zenitheesc/garatea3/Structure/main-structure/internal-assembly.SLDASM

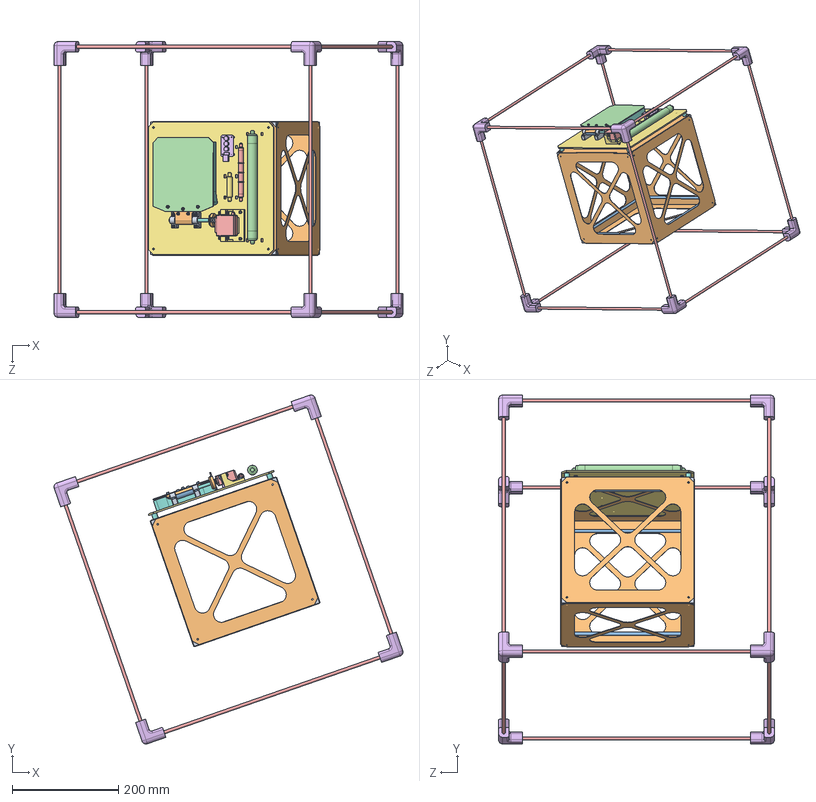
[picture p1: CAD file, 2021-04-19]
Structure/main-structure/internal-assembly.SLDASM
657.4 x 657.4 x 520.0 mm
Conector-int_1 x 8
Placa-ext_1 x 6
tubo-int-hor_1 x 8
tubo-int-vert_1 x 4
Tubo-ext_1 x 12
Conector-ext_1 x 8
chapa
base_experimento
mancal1 x 2
suporte_tampa
suporte_tampa2
tampa_experimento
Servo_motor_maior
hex nut style 1_am x 7
suporte_servo
eixo
uniao_servo
uniao_eixo1
socket head cap screw_am x 13
geiger_maior
geiger_CTC5
placa_fotodiodos
geiger_SI3BG
espaçador x 4
