zenitheesc/garatea3/Structure/main-structure/external-assembly.sldasm

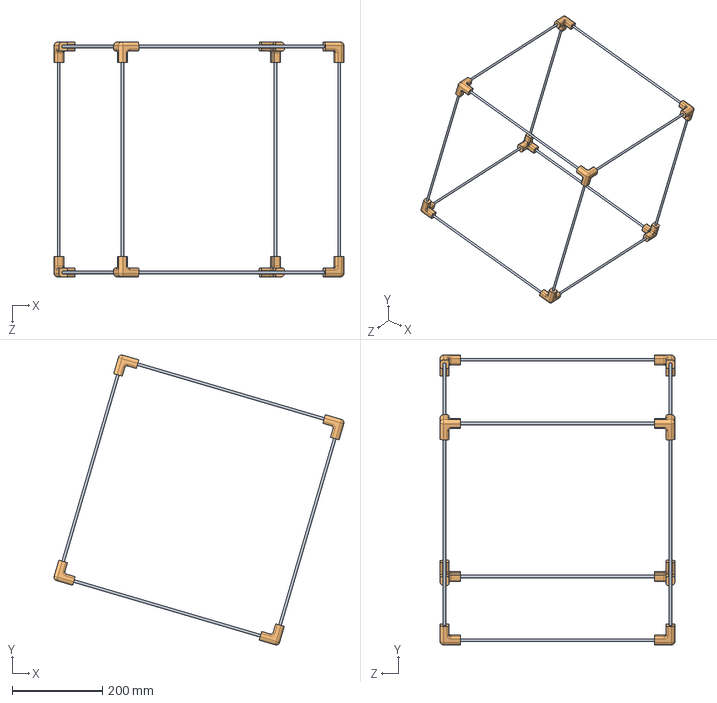
[picture p2: CAD file, 2021-04-19]
Structure/main-structure/external-assembly.sldasm
641.6 x 641.6 x 520.0 mm
Tubo-ext_1 x 12
Conector-ext_1 x 8
