zenitheesc/garatea3/Structure/main-structure/final-assembly.SLDASM

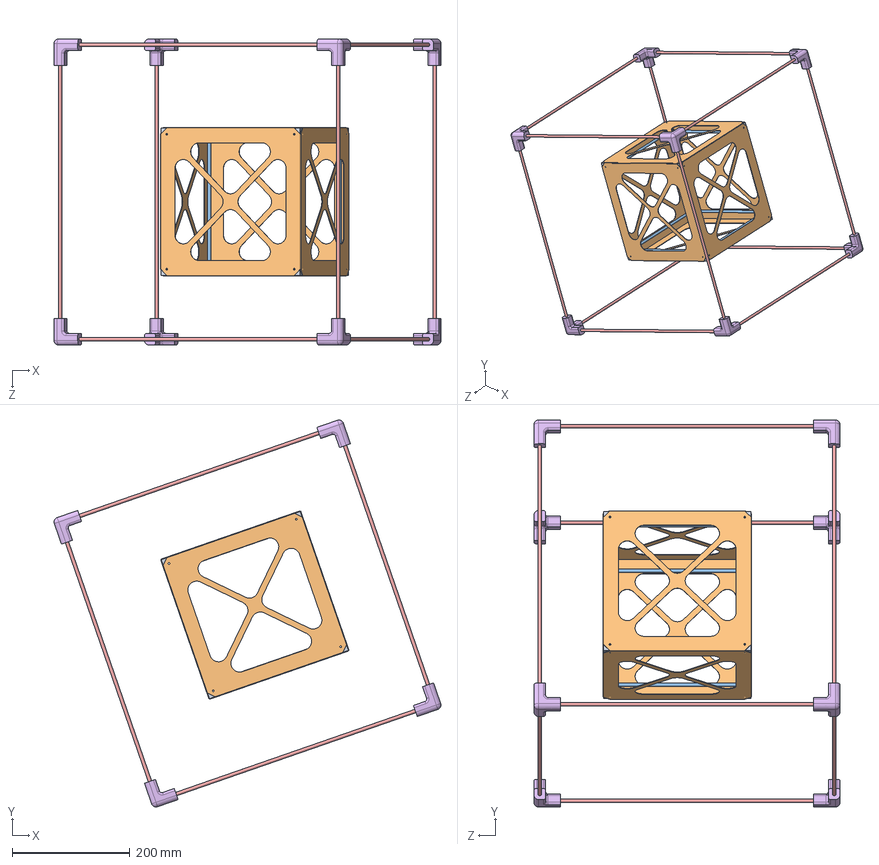
[picture p3: CAD file, 2021-04-19]
Structure/main-structure/final-assembly.SLDASM
657.4 x 657.4 x 520.0 mm
Conector-int x 8
Placa-ext x 6
tubo-int-hor x 8
tubo-int-vert x 4
Tubo-ext x 12
Conector-ext x 8
