zenitheesc/garatea3/Structure/mechanism/support-slave.STL

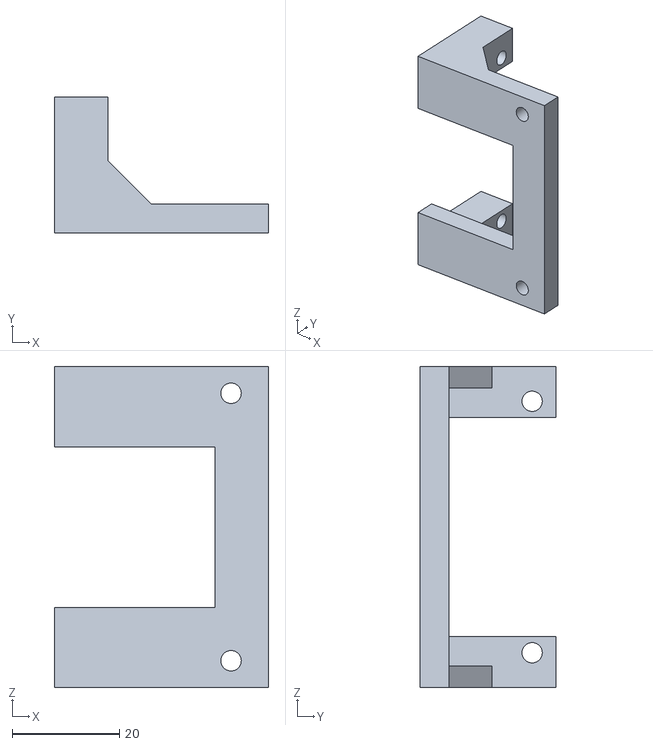
[picture p4: CAD file, 2021-04-19]
Structure/mechanism/support-slave.STL
40.0 x 25.5 x 60.0
