zenitheesc/garatea3/Structure/mechanism/union.STL

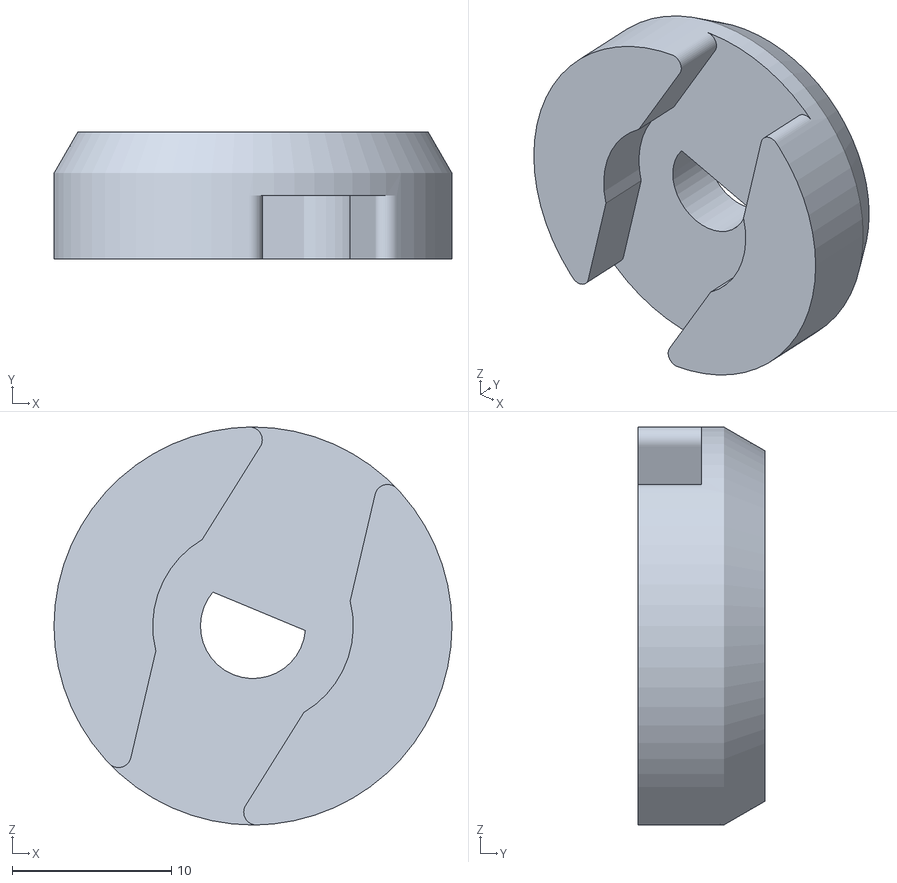
[picture p5: CAD file, 2021-04-19]
Structure/mechanism/union.STL
25.0 x 8.00 x 25.0
