zenitheesc/garatea3/Structure/main-structure/external-board.sldprt

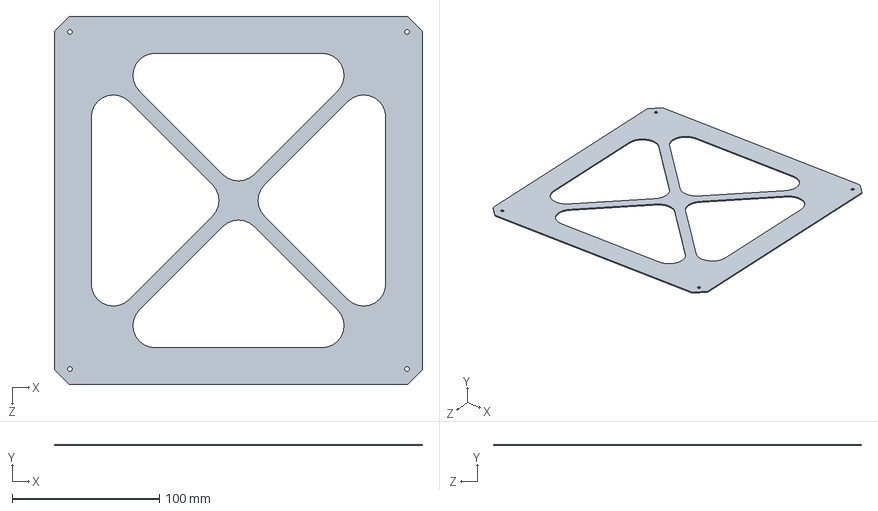
[picture p6: CAD file, 2021-04-19]
Structure/main-structure/external-board.sldprt
250.0 x 1.00 x 250.0 mm
