zenitheesc/garatea3/Structure/mechanism/bearing.STL

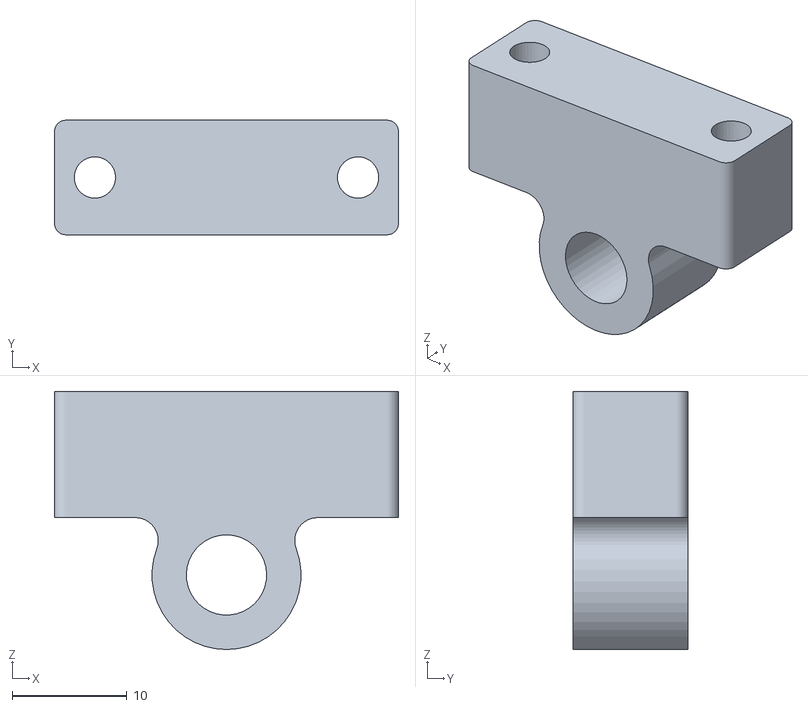
[picture p7: CAD file, 2021-04-19]
Structure/mechanism/bearing.STL
30.0 x 10.0 x 22.5
