zenitheesc/garatea3/Structure/main-structure/internal-vertical-tube.sldprt

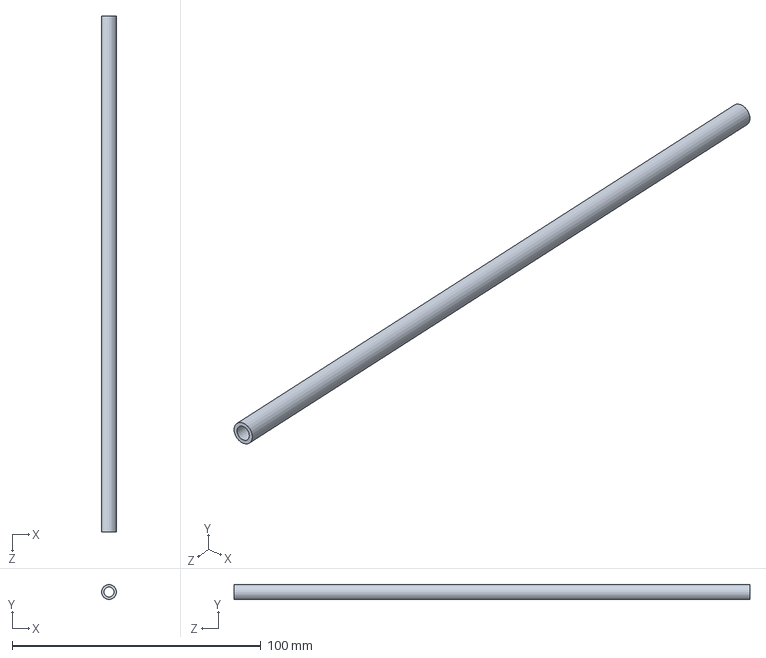
[picture p8: CAD file, 2021-04-19]
Structure/main-structure/internal-vertical-tube.sldprt
6.00 x 6.00 x 207.5 mm
