zenitheesc/garatea3/Structure/mechanism/support-cover.STL

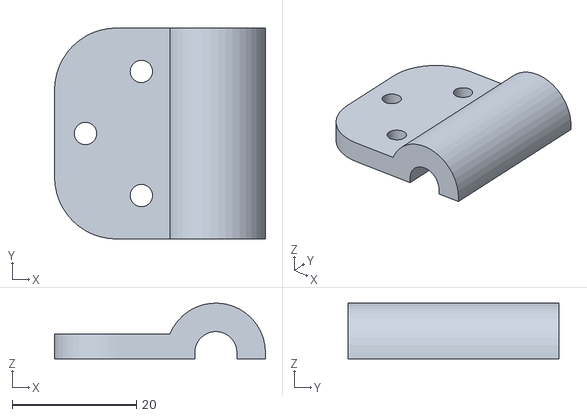
[picture p9: CAD file, 2021-04-19]
Structure/mechanism/support-cover.STL
34.0 x 34.0 x 8.99
