zenitheesc/garatea3/Structure/main-structure/internal-horizontal-tube.sldprt

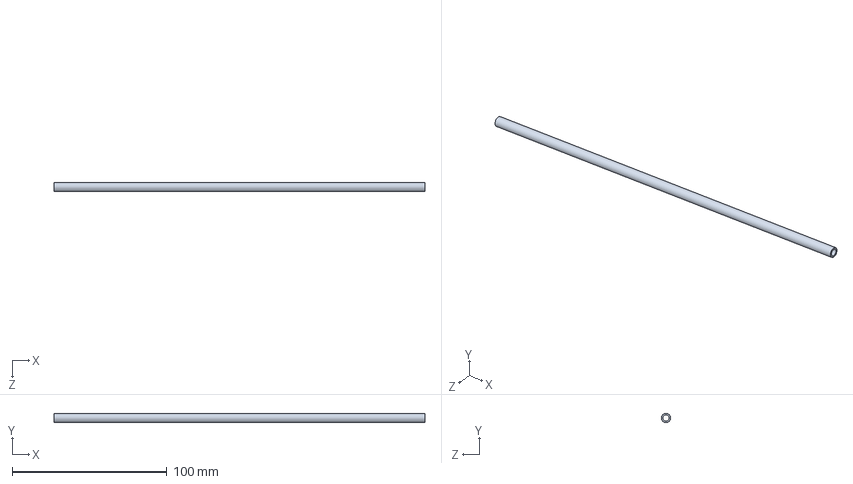
[picture p10: CAD file, 2021-04-19]
Structure/main-structure/internal-horizontal-tube.sldprt
240.0 x 6.00 x 6.00 mm
