zenitheesc/garatea3/Structure/mechanism/experiment-base.STL

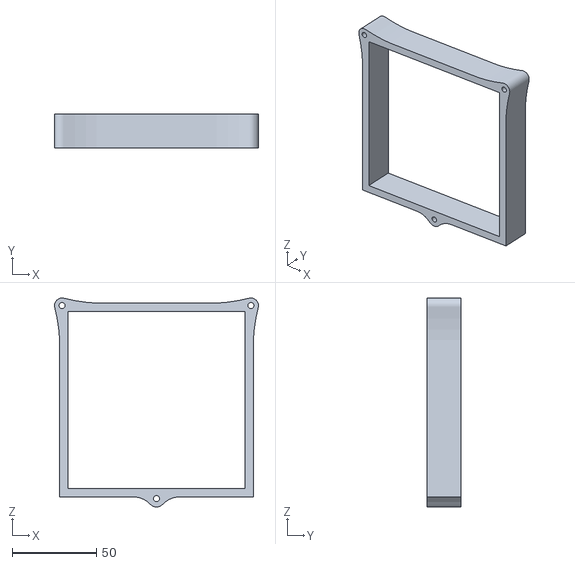
[picture p11: CAD file, 2021-04-19]
Structure/mechanism/experiment-base.STL
121.1 x 20.0 x 124.0
