zenitheesc/garatea3/Structure/main-structure/internal-connector.stl

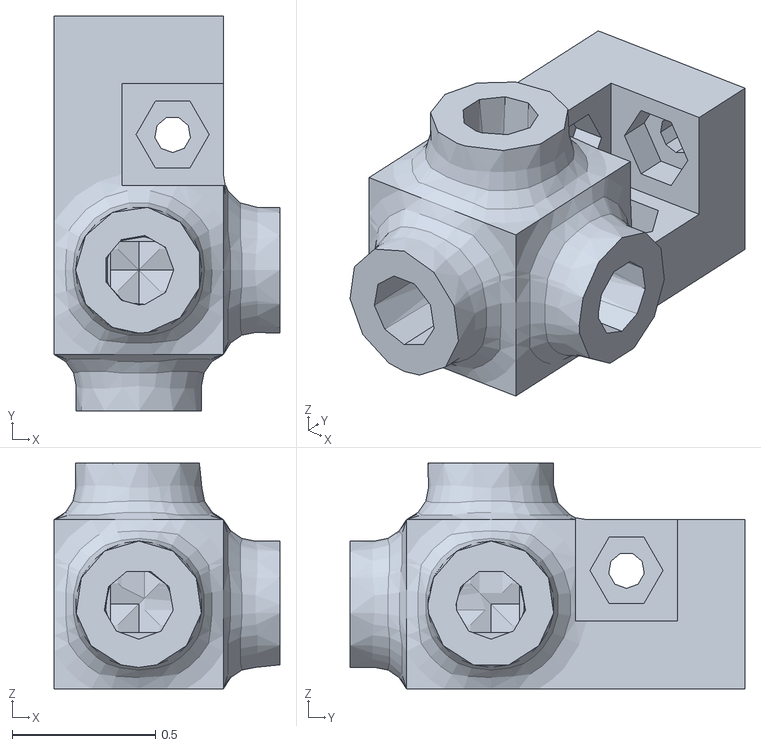
[picture p12: CAD file, 2021-04-19]
Structure/main-structure/internal-connector.stl
0.787 x 1.38 x 0.787
