zenitheesc/garatea3/Structure/main-structure/external-connector.stl

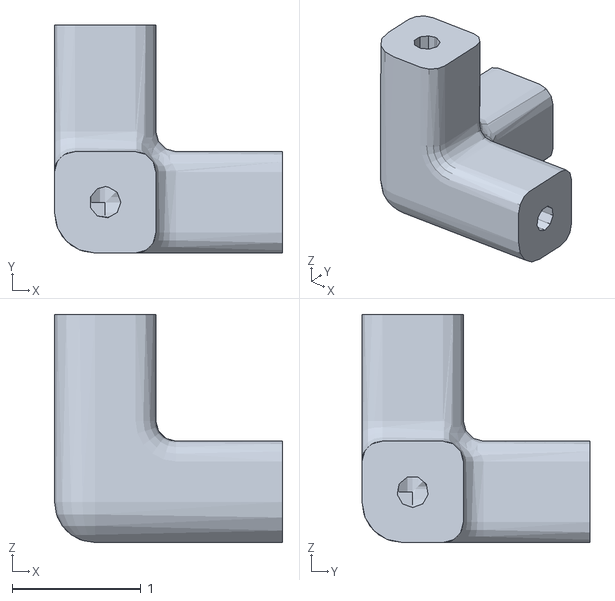
[picture p13: CAD file, 2021-04-19]
Structure/main-structure/external-connector.stl
1.77 x 1.77 x 1.77
