zenitheesc/garatea3/Structure/main-structure/external-tube.sldprt

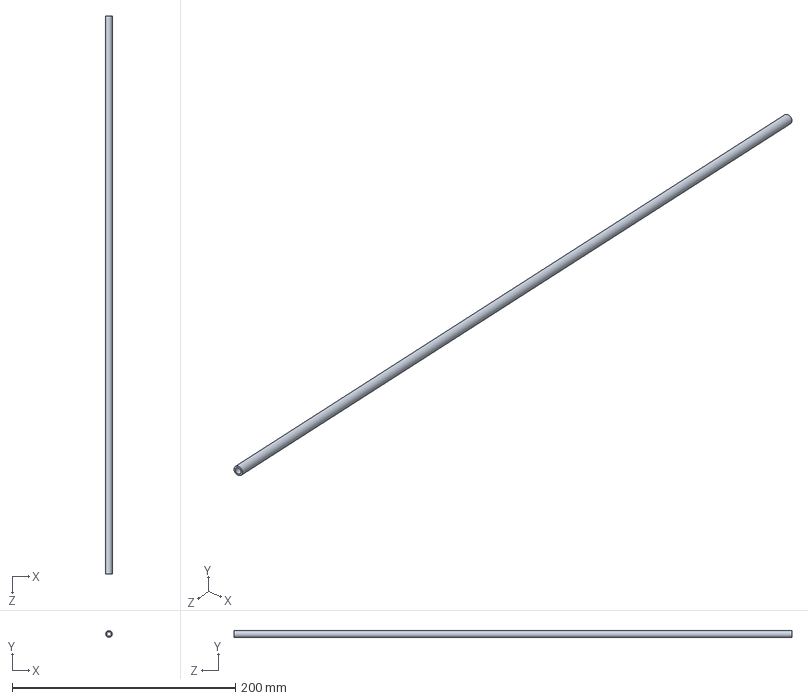
[picture p14: CAD file, 2021-04-19]
Structure/main-structure/external-tube.sldprt
6.00 x 6.00 x 500.0 mm
