zenitheesc/garatea3/(list of files, cad)

Other CAD files:
Structure/main-structure/external-assembly.stl
Structure/main-structure/external-board.stl
Structure/main-structure/external-tube.stl
Structure/main-structure/internal-horizontal-tube.stl
Structure/main-structure/internal-vertical-tube.stl
