zenitheesc/garatea3/Hardware/photodiodes-board/photodiodes-board.brd

## EAGLE design Hardware/photodiodes-board/photodiodes-board.brd (2021-04-19)

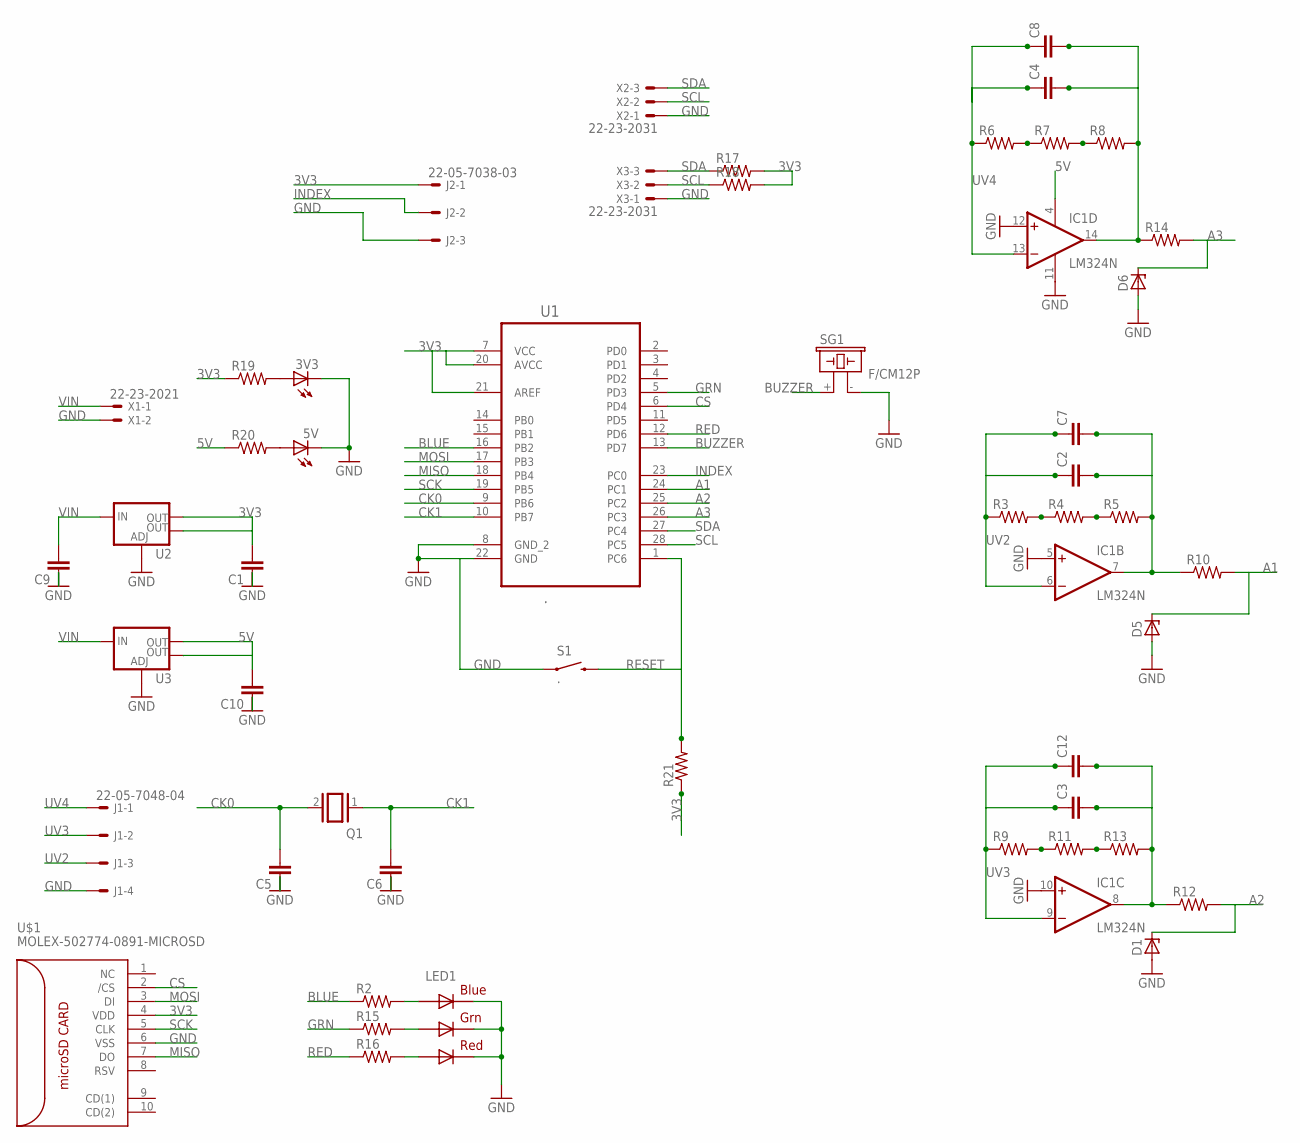
[picture p15: schematic photodiodes-board.sch]

Parts:
3V3, 5V: LEDSMT1206; 1206
C1, C2, C3, C4, C5, C6, C7, C8, C9, C10, C12: 10UF-1210-50V-20%; 1210
D1, D5, D6: ZENER-DIODEZD-12.5; ZDIO12.5
IC1: LM324N; DIL14
J1: 22-05-7048-04; 7395-04
J2: 22-05-7038-03; 7395-03
LED1: .; RGBLED5050
Q1: XTAL/S; QS
R2, R10, R12, R14, R15, R16, R17, R18, R19, R20, R21: R-US_M1206; M1206
R3, R4, R5, R6, R7, R8, R9, R11, R13: R-US_0207/12; 0207/12
S1: .; TACTILE-SWITCH-1101NE
SG1: F/CM12P
U1: .; DIP254P762X457-28
U2, U3: V_REG_LM1117SOT223; SOT223
U$1: MOLEX-502774-0891-MICROSD
X1: 22-23-2021
X2, X3: 22-23-2031

Connections:
3V3: C1.2, J2.1, R17.2, R18.2, R19.1, R21.1, U1.7 (VCC), U1.20 (AVCC), U1.21 (AREF), U2.2 (OUT), U2.4 (OUT), U$1.4 (VDD)
5V: C10.2, IC1.4 (V+), R20.1, U3.2 (OUT), U3.4 (OUT)
A1: D5.C, R10.2, U1.24 (PC1)
A2: D1.C, R12.2, U1.25 (PC2)
A3: D6.C, R14.2, U1.26 (PC3)
BLUE: R2.1, U1.16 (PB2)
BUZZER: SG1.+ (1), U1.13 (PD7)
CK0: C5.2, Q1.2, U1.9 (PB6)
CK1: C6.2, Q1.1, U1.10 (PB7)
CS: U1.6 (PD4), U$1.2 (/CS)
GND: 3V3.C, 5V.C, C1.1, C5.1, C6.1, C9.1, C10.1, D1.A, D5.A, D6.A, IC1.5 (+IN), IC1.10 (+IN), IC1.11 (V-), IC1.12 (+IN), J1.4, J2.3, LED1.4 (BLUE_C), LED1.5 (RED_C), LED1.6 (GREEN_C), S1.1, SG1.- (2), U1.8 (GND_2), U1.22 (GND), U2.1 (ADJ), U3.1 (ADJ), U$1.6 (VSS), X1.2, X2.1, X3.1
GRN: R15.1, U1.5 (PD3)
INDEX: J2.2, U1.23 (PC0)
MISO: U1.18 (PB4), U$1.7 (DO)
MOSI: U1.17 (PB3), U$1.3 (DI)
unnamed: R3.2, R4.1
unnamed: R4.2, R5.1
unnamed: R6.2, R7.1
unnamed: R7.2, R8.1
unnamed: R9.2, R11.1
unnamed: R11.2, R13.1
unnamed: LED1.3 (BLUE_A), R2.2
unnamed: LED1.1 (GREEN_A), R15.2
unnamed: LED1.2 (RED_A), R16.2
unnamed: 3V3.A, R19.2
unnamed: 5V.A, R20.2
unnamed: C4.2, C8.2, IC1.14 (OUT), R8.2, R14.1
unnamed: C3.2, C12.2, IC1.8 (OUT), R12.1, R13.2
unnamed: C2.2, C7.2, IC1.7 (OUT), R5.2, R10.1
RED: R16.1, U1.12 (PD6)
RESET: R21.2, S1.2, U1.1 (PC6)
SCK: U1.19 (PB5), U$1.5 (CLK)
SCL: R18.1, U1.28 (PC5), X2.2, X3.2
SDA: R17.1, U1.27 (PC4), X2.3, X3.3
UV2: C2.1, C7.1, IC1.6 (-IN), J1.3, R3.1
UV3: C3.1, C12.1, IC1.9 (-IN), J1.2, R9.1
UV4: C4.1, C8.1, IC1.13 (-IN), J1.1, R6.1
VIN: C9.2, U2.3 (IN), U3.3 (IN), X1.1

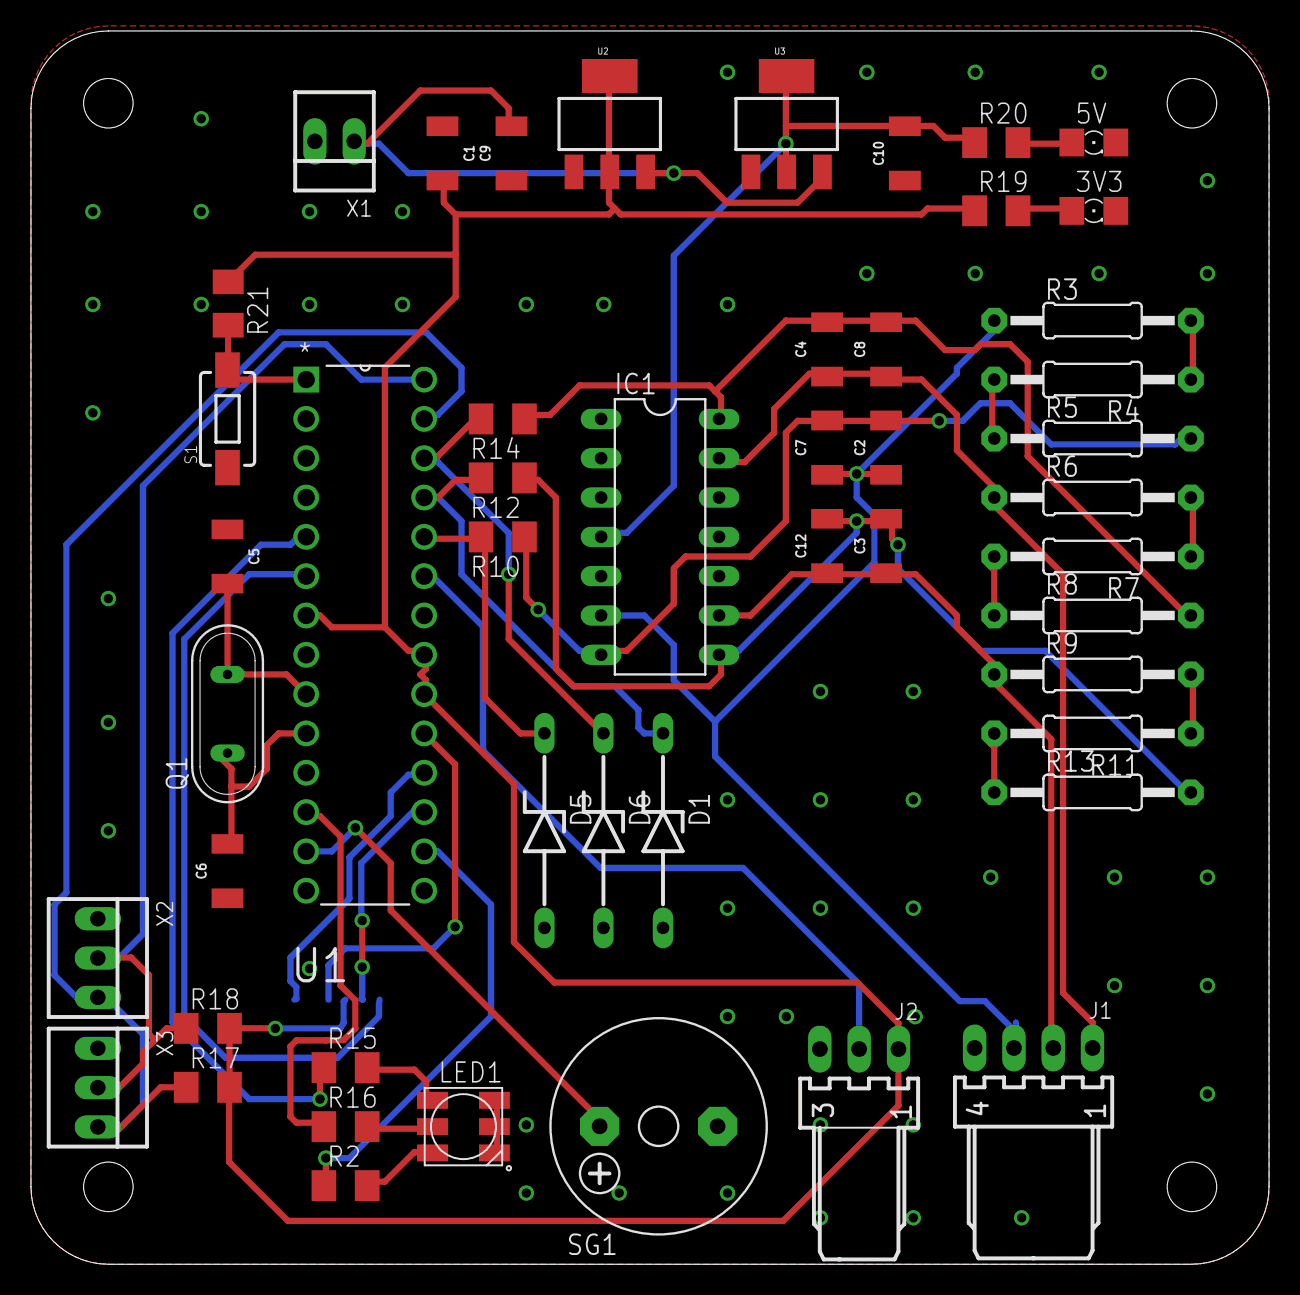
[picture p16: board photodiodes-board.brd from above]

Board: 2 copper layers, 80.0 x 79.7 mm, 50 parts (1 on the bottom side), 38 nets.
