zenitheesc/garatea3/Hardware/geiger-board/geiger-board.brd

## EAGLE design Hardware/geiger-board/geiger-board.brd (2021-04-19)

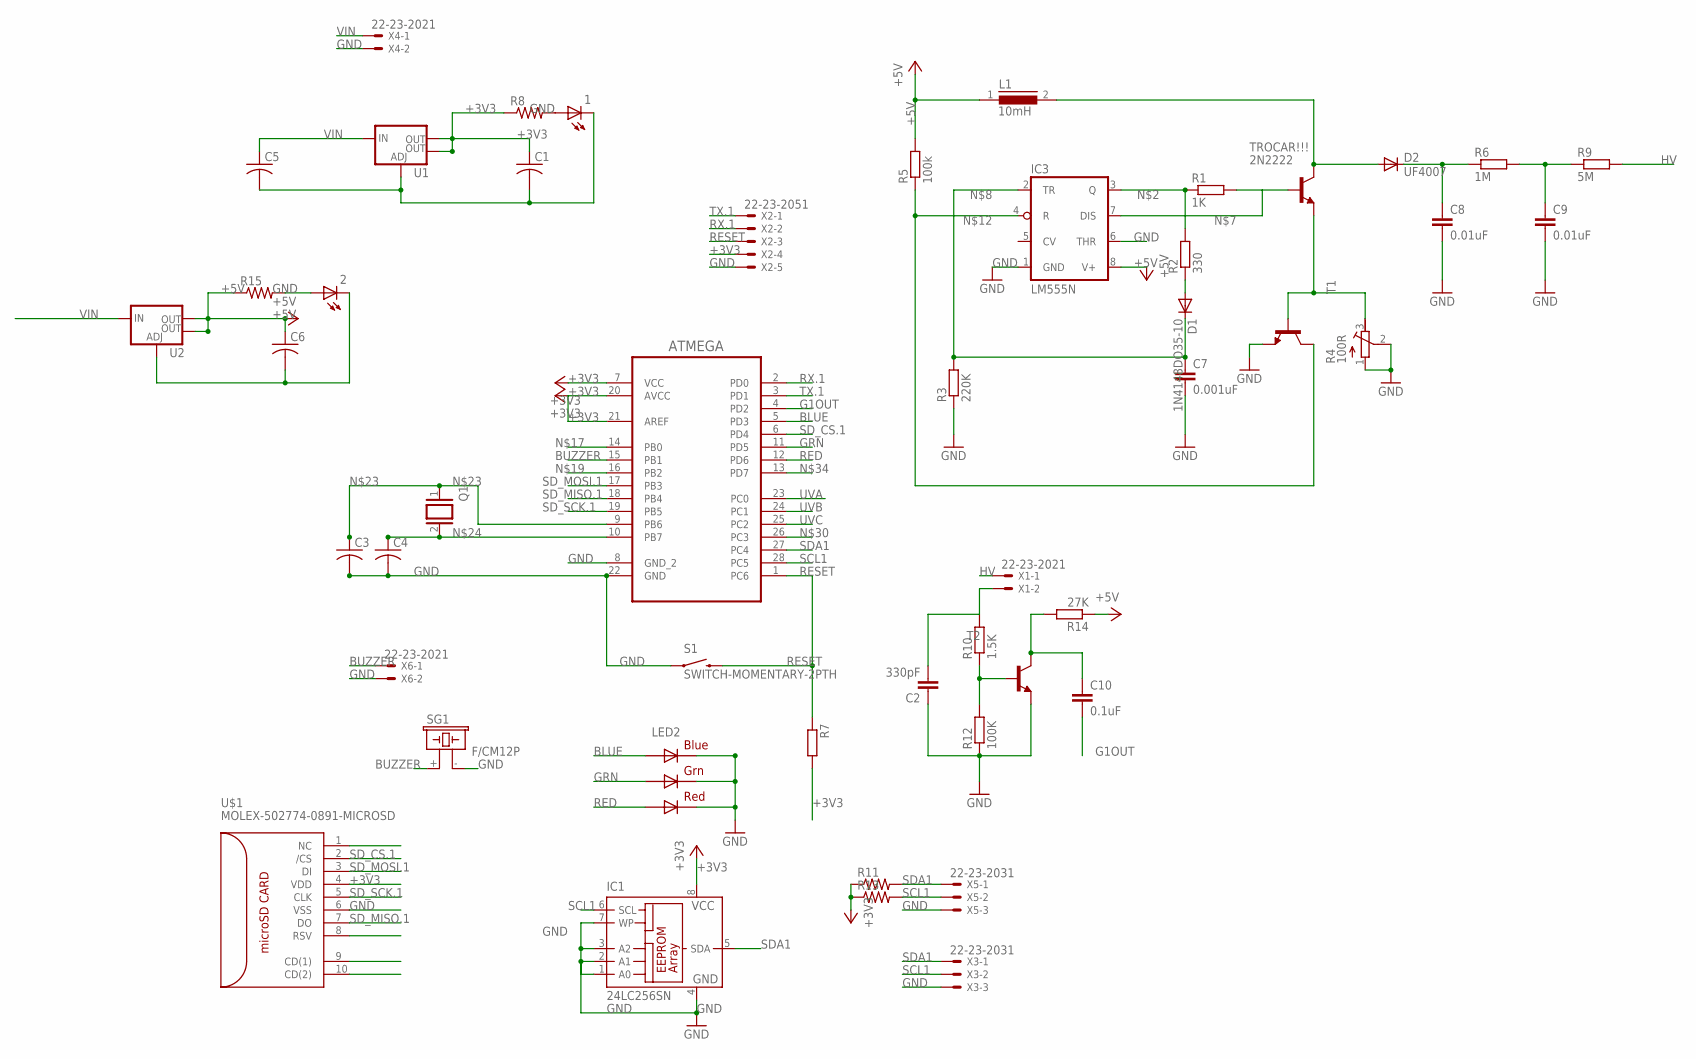
[picture p17: schematic geiger-board.sch]

Parts:
1, 2: LEDSMT1206; 1206
ATMEGA: ATMEGA328P-PU; DIP254P762X457-28
C1, C3, C4, C5, C6: C-USC1210K; C1210K
C2: 330pF; C5B4.5
C7: 0.001uF; C5B4.5
C8, C9: 0.01uF; C5B4.5
C10: 0.1uF; C5B4.5
D1: 1N4148DO35-10; DO35-10
D2: UF4007; DO35-10
IC1: 24LC256SN; SO-08
IC3: LM555N; DIL08-ROUND
L1: 10mH; 82114R
LED2: RGBLED5050
Q1: XTAL/S; QS
R1: 1K; 0207/10
R2: 330; 0207/10
R3: 220K; 0207/10
R4: 100R; RTRIM3296W
R5: 100k; 0207/10
R6: 1M; 0207/10
R7: R-EU_0207/10; 0207/10
R8, R15: R-US_M1206; M1206
R9: 5M; 0207/10
R10: 1.5K; 0207/10
R11, R13: R-US_R1206; R1206
R12: 100K; 0207/10
R14: 27K; 0207/10
S1: SWITCH-MOMENTARY-2PTH; TACTILE-PTH
SG1: F/CM12P
T1, T2: 2N4401-NPN-TO92-EBC; TO92-EBC
TROCAR!!!: 2N2222; TO92-EBC-OVAL
U1, U2: V_REG_LM1117SOT223; SOT223
U$1: MOLEX-502774-0891-MICROSD
X1, X4, X6: 22-23-2021
X2: 22-23-2051
X3, X5: 22-23-2031

Connections:
+3V3: ATMEGA.7 (VCC), ATMEGA.20 (AVCC), ATMEGA.21 (AREF), C1.1, IC1.8 (VCC), R7.2, R8.1, R11.1, R13.1, U1.2 (OUT), U1.4 (OUT), U$1.4 (VDD), X2.4
+5V: C6.1, IC3.8 (V+), L1.1, R5.2, R14.1, R15.1, U2.2 (OUT), U2.4 (OUT)
BLUE: ATMEGA.5 (PD3), LED2.3 (BLUE_A)
BUZZER: ATMEGA.15 (PB1), SG1.+ (1), X6.1
G1OUT: ATMEGA.4 (PD2), C10.2
GND: 1.C, 2.C, ATMEGA.8 (GND_2), ATMEGA.22 (GND), C1.2, C2.1, C3.2, C4.2, C5.2, C6.2, C7.2, C8.2, C9.2, IC1.1 (A0), IC1.2 (A1), IC1.3 (A2), IC1.4 (GND), IC1.7 (WP), IC3.1 (GND), IC3.6 (THR), LED2.4 (BLUE_C), LED2.5 (RED_C), LED2.6 (GREEN_C), R3.1, R4.1 (A), R4.2 (S), R12.1, S1.1, SG1.- (2), T1.E, T2.E, U1.1 (ADJ), U2.1 (ADJ), U$1.6 (VSS), X2.5, X3.3, X4.2, X5.3, X6.2
GRN: ATMEGA.11 (PD5), LED2.1 (GREEN_A)
HV: R9.2, X1.1
unnamed: 1.A, R8.2
unnamed: IC3.3 (Q), R1.1, R2.2
unnamed: 2.A, R15.2
unnamed: D1.A, R2.1
unnamed: IC3.7 (DIS), R1.2, TROCAR!!!.B
unnamed: C7.1, D1.C, IC3.2 (TR), R3.2
unnamed: D2.A, L1.2, TROCAR!!!.C
unnamed: C8.1, D2.C, R6.1
unnamed: IC3.4 (R), R5.1, T1.C
unnamed: C9.1, R6.2, R9.1
unnamed: C2.2, R10.2, X1.2
unnamed: R4.3 (E), T1.B, TROCAR!!!.E
unnamed: R10.1, R12.2, T2.B
unnamed: ATMEGA.9 (PB6), C3.1, Q1.1
unnamed: ATMEGA.10 (PB7), C4.1, Q1.2
unnamed: C10.1, R14.2, T2.C
RED: ATMEGA.12 (PD6), LED2.2 (RED_A)
RESET: ATMEGA.1 (PC6), R7.1, S1.3 (2), X2.3
RX.1: ATMEGA.2 (PD0), X2.2
SCL1: ATMEGA.28 (PC5), IC1.6 (SCL), R13.2, X3.2, X5.2
SDA1: ATMEGA.27 (PC4), IC1.5 (SDA), R11.2, X3.1, X5.1
SD_CS.1: ATMEGA.6 (PD4), U$1.2 (/CS)
SD_MISO.1: ATMEGA.18 (PB4), U$1.7 (DO)
SD_MOSI.1: ATMEGA.17 (PB3), U$1.3 (DI)
SD_SCK.1: ATMEGA.19 (PB5), U$1.5 (CLK)
TX.1: ATMEGA.3 (PD1), X2.1
UVA: ATMEGA.23 (PC0)
UVB: ATMEGA.24 (PC1)
UVC: ATMEGA.25 (PC2)
VIN: C5.1, U1.3 (IN), U2.3 (IN), X4.1

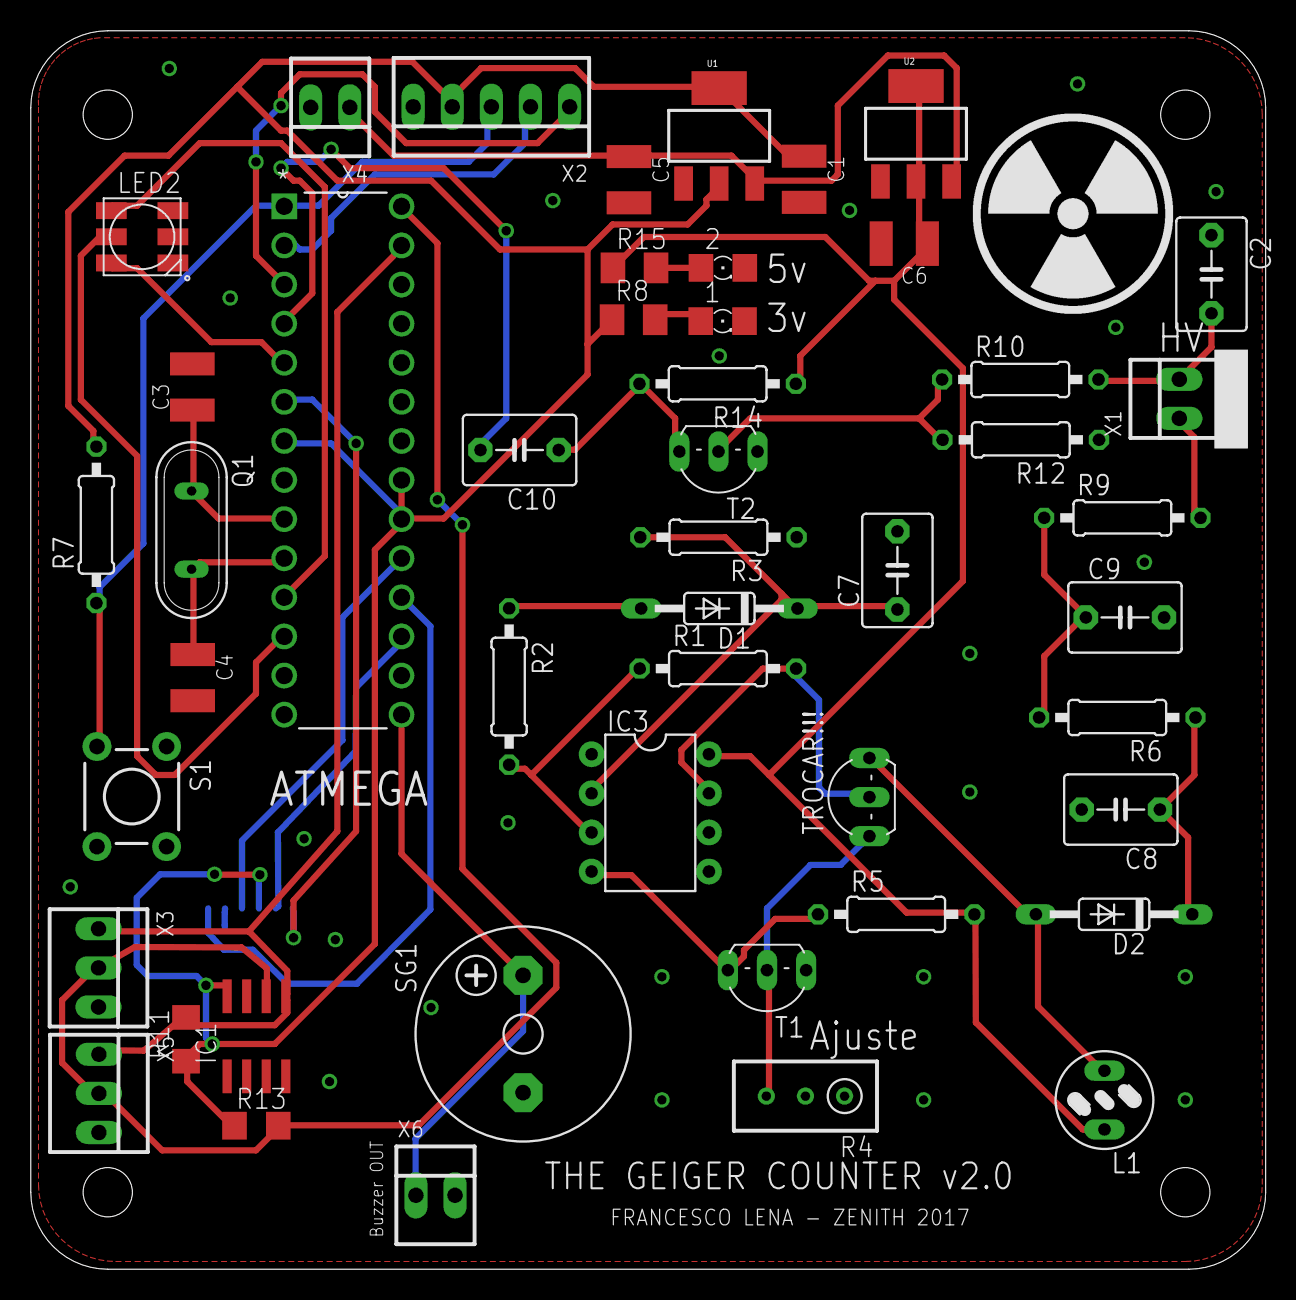
[picture p18: board geiger-board.brd from above]

Board: 2 copper layers, 80.2 x 80.5 mm, 49 parts (1 on the bottom side), 35 nets.
