zenitheesc/garatea3/Hardware/debugger-board/debugger-board.brd

## EAGLE design Hardware/debugger-board/debugger-board.brd (2021-04-19)

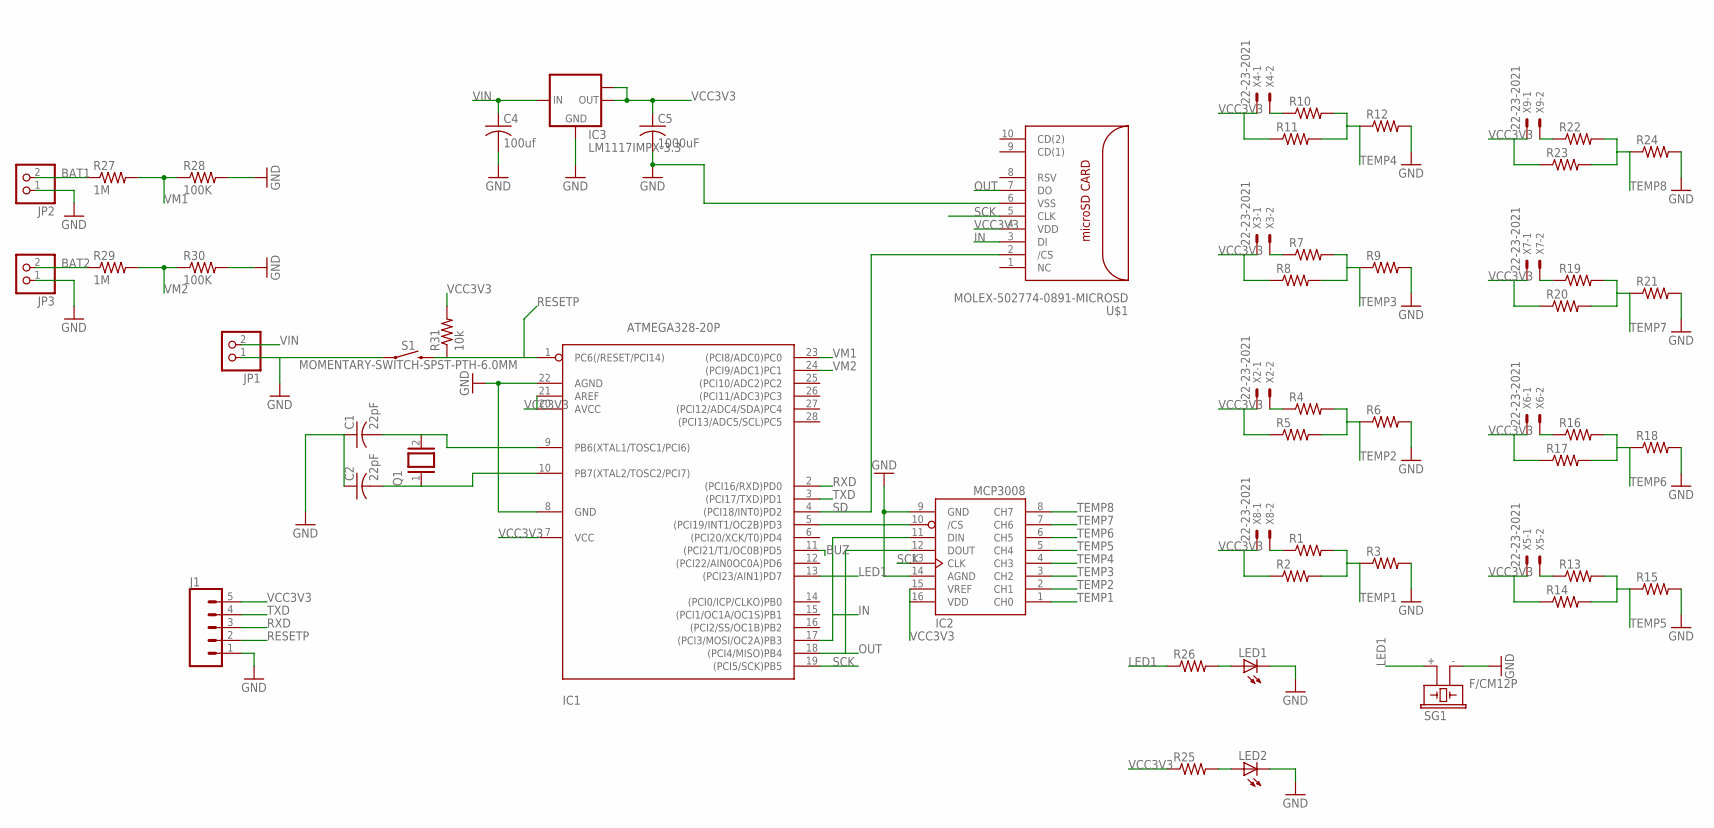
[picture p19: schematic debugger-board.sch]

Parts:
C1, C2: 22pF; C050-025X075
C4: 100uf; C050-025X075
C5: 1000uF; C050-025X075
IC1: ATMEGA328-20P; DIL28-3
IC2: MCP3008; DIL16
IC3: LM1117IMPX-3.3; SOT223
J1: CONN_05PTH_LONGPADS; 1X05_LONGPADS
JP1, JP2, JP3: PINHD-1X2; 1X02
LED1, LED2: LED_ELD260; LED_LD260
Q1: XTAL/S; QS
R1, R2, R3, R4, R5, R6, R7, R8, R9, R10, R11, R12, R13, R14, R15, R16, R17, R18, R19, R20, R21, R22, R23, R24, R25, R26: R-US_0204/5; 0204/5
R27, R29: 1M; 0204/5
R28, R30: 100K; 0204/5
R31: 10k; 0207/7
S1: MOMENTARY-SWITCH-SPST-PTH-6.0MM; TACTILE_SWITCH_PTH_6.0MM
SG1: F/CM12P
U$1: MOLEX-502774-0891-MICROSD
X2, X3, X4, X5, X6, X7, X8, X9: 22-23-2021

Connections:
BAT1: JP2.2, R27.1
BAT2: JP3.2, R29.1
BUZ: IC1.11 ((PCI21/T1/OC0B)PD5)
GND: C1.1, C2.1, C4.2, C5.2, IC1.8 (GND), IC1.22 (AGND), IC2.9 (GND), IC2.14 (AGND), IC3.1 (GND), J1.1, JP1.1, JP2.1, JP3.1, LED1.K (C), LED2.K (C), R3.2, R6.2, R9.2, R12.2, R15.2, R18.2, R21.2, R24.2, R28.2, R30.2, S1.1, SG1.- (2), U$1.6 (VSS)
IN: IC1.17 ((PCI3/MOSI/OC2A)PB3), IC2.11 (DIN), U$1.3 (DI)
LED1: IC1.13 ((PCI23/AIN1)PD7), R26.1, SG1.+ (1)
unnamed: LED2.A, R25.2
unnamed: IC1.5 ((PCI19/INT1/OC2B)PD3), IC2.10 (/CS)
unnamed: C1.2, IC1.9 (PB6(XTAL1/TOSC1/PCI6)), Q1.2
unnamed: C2.2, IC1.10 (PB7(XTAL2/TOSC2/PCI7)), Q1.1
unnamed: R4.1, X2.2
unnamed: R1.1, X8.2
unnamed: LED1.A, R26.2
unnamed: R7.1, X3.2
unnamed: R10.1, X4.2
unnamed: R13.1, X5.2
unnamed: R16.1, X6.2
unnamed: R19.1, X7.2
unnamed: R22.1, X9.2
OUT: IC1.18 ((PCI4/MISO)PB4), IC2.12 (DOUT), U$1.7 (DO)
RESETP: IC1.1 (PC6(/RESET/PCI14)), J1.2, R31.1, S1.3 (2)
RXD: IC1.2 ((PCI16/RXD)PD0), J1.3
SCK: IC1.19 ((PCI5/SCK)PB5), IC2.13 (CLK), U$1.5 (CLK)
SD: IC1.4 ((PCI18/INT0)PD2), U$1.2 (/CS)
TEMP1: IC2.1 (CH0), R1.2, R2.2, R3.1
TEMP2: IC2.2 (CH1), R4.2, R5.2, R6.1
TEMP3: IC2.3 (CH2), R7.2, R8.2, R9.1
TEMP4: IC2.4 (CH3), R10.2, R11.2, R12.1
TEMP5: IC2.5 (CH4), R13.2, R14.2, R15.1
TEMP6: IC2.6 (CH5), R16.2, R17.2, R18.1
TEMP7: IC2.7 (CH6), R19.2, R20.2, R21.1
TEMP8: IC2.8 (CH7), R22.2, R23.2, R24.1
TXD: IC1.3 ((PCI17/TXD)PD1), J1.4
VCC3V3: C5.1, IC1.7 (VCC), IC1.20 (AVCC), IC1.21 (AREF), IC2.15 (VREF), IC2.16 (VDD), IC3.2 (OUT), IC3.TAB (OUT1), J1.5, R2.1, R5.1, R8.1, R11.1, R14.1, R17.1, R20.1, R23.1, R25.1, R31.2, U$1.4 (VDD), X2.1, X3.1, X4.1, X5.1, X6.1, X7.1, X8.1, X9.1
VIN: C4.1, IC3.3 (IN), JP1.2
VM1: IC1.23 ((PCI8/ADC0)PC0), R27.2, R28.1
VM2: IC1.24 ((PCI9/ADC1)PC1), R29.2, R30.1

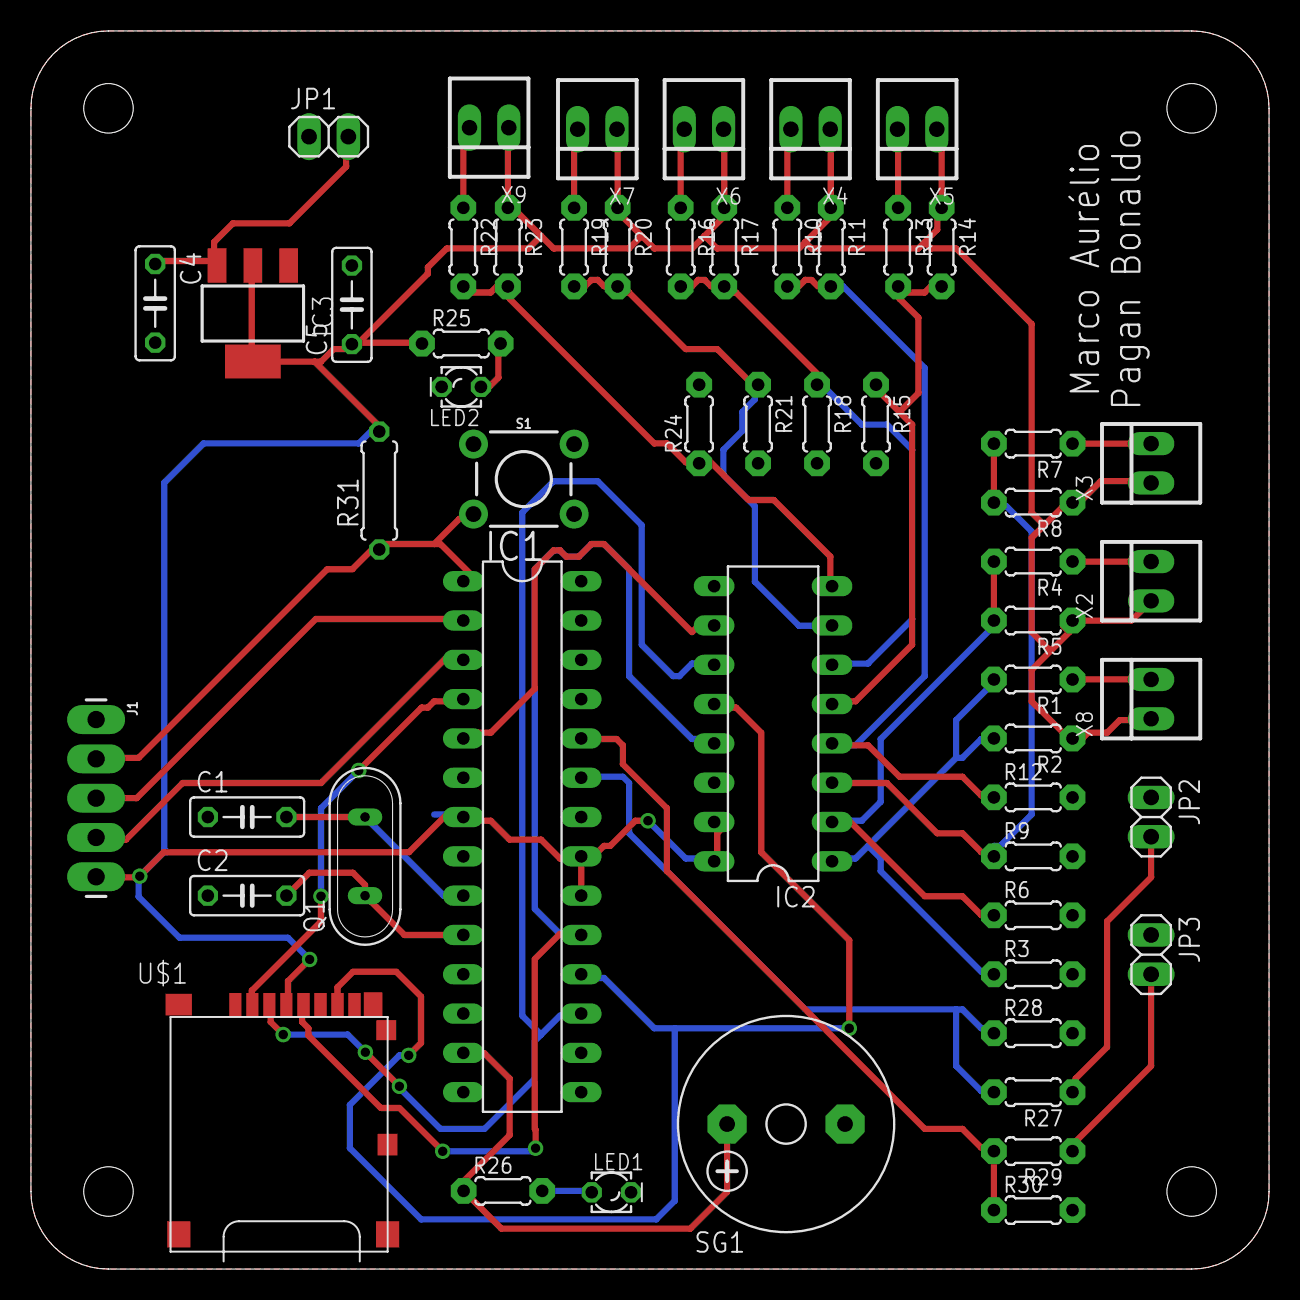
[picture p20: board debugger-board.brd from above]

Board: 2 copper layers, 80.0 x 80.0 mm, 56 parts (0 on the bottom side), 36 nets.
