zenitheesc/garatea3/Hardware/garatea-board/garatea-board.brd

## EAGLE design Hardware/garatea-board/garatea-board.brd (2021-04-19)

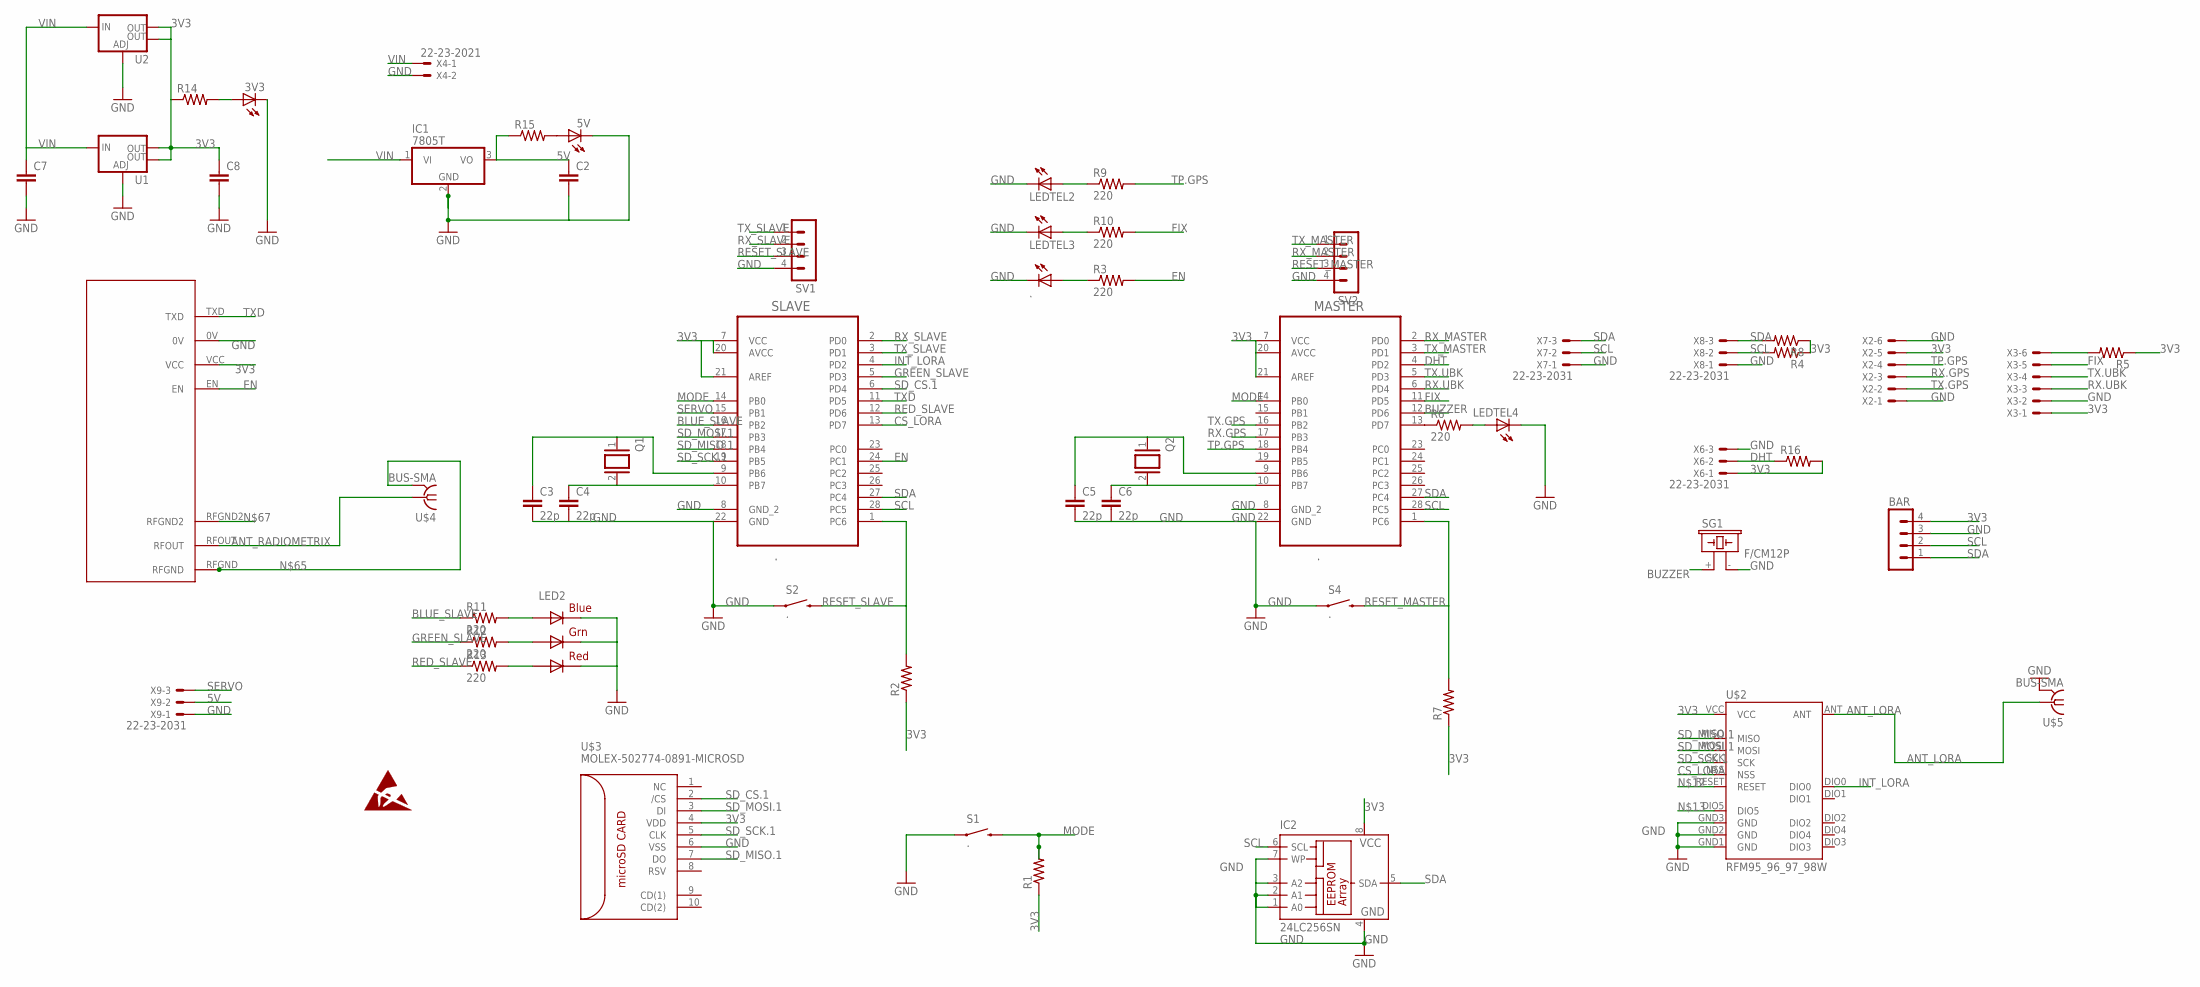
[picture p21: schematic garatea-board.sch]

Parts:
3V3, 5V, .: LEDSMT1206; 1206
BAR: MA04-1
C2, C7, C8: 10UF-1210-50V-20%; 1210
C3, C4, C5, C6: 22p; 1210
IC1: 7805T; TO220H
IC2: 24LC256SN; SO-08
LED2: RGBLED5050
LEDTEL2, LEDTEL3, LEDTEL4: LEDSMT1206; 1206
MASTER: .; DIP254P762X457-28
Q1, Q2: XTAL/S; QS
R1, R2, R4, R5, R7, R8, R14, R15, R16: R-US_M1206; M1206
R3, R6, R9, R10, R11, R12, R13: 220; M1206
S1, S2, S4: .; TACTILE-SWITCH-1101NE
SG1: F/CM12P
SLAVE: .; DIP254P762X457-28
SV1, SV2: MA04-1
U1, U2: V_REG_LM1117SOT223; SOT223
U$1: NTX2
U$2: RFM95_96_97_98W
U$3: MOLEX-502774-0891-MICROSD
U$4, U$5: BUS-SMA
X2, X3: 22-23-2061
X4: 22-23-2021
X6, X7, X8, X9: 22-23-2031

Connections:
3V3: BAR.4, C8.1, IC2.8 (VCC), MASTER.7 (VCC), MASTER.20 (AVCC), MASTER.21 (AREF), R1.1, R2.1, R4.1, R5.1, R7.1, R8.1, R14.1, R16.2, SLAVE.7 (VCC), SLAVE.20 (AVCC), SLAVE.21 (AREF), U1.2 (OUT), U1.4 (OUT), U2.2 (OUT), U2.4 (OUT), U$1.VCC, U$2.VCC, U$3.4 (VDD), X2.5, X3.1, X6.1
5V: C2.1, IC1.3 (VO), R15.1, X9.2
ANT_LORA: U$2.ANT, U$5.1
ANT_RADIOMETRIX: U$1.RFOUT, U$4.1
BLUE_SLAVE: R11.1, SLAVE.16 (PB2)
BUZZER: MASTER.12 (PD6), SG1.+ (1)
CS_LORA: SLAVE.13 (PD7), U$2.NSS
DHT: MASTER.4 (PD2), R16.1, X6.2
EN: R3.2, SLAVE.24 (PC1), U$1.EN
EN.UBK: R5.2, X3.6
FIX: MASTER.11 (PD5), R10.2, X3.5
GND: 3V3.C, 5V.C, ..C, BAR.3, C2.2, C3.2, C4.2, C5.2, C6.2, C7.2, C8.2, IC1.2 (GND), IC2.1 (A0), IC2.2 (A1), IC2.3 (A2), IC2.4 (GND), IC2.7 (WP), LED2.4 (BLUE_C), LED2.5 (RED_C), LED2.6 (GREEN_C), LEDTEL2.C, LEDTEL3.C, LEDTEL4.C, MASTER.8 (GND_2), MASTER.22 (GND), S1.1, S2.1, S4.1, SG1.- (2), SLAVE.8 (GND_2), SLAVE.22 (GND), SV1.4, SV2.4, U1.1 (ADJ), U2.1 (ADJ), U$1.0V, U$2.GND1 (GND), U$2.GND2 (GND), U$2.GND3 (GND), U$3.6 (VSS), U$5.2 (GND), U$5.3 (GND), U$5.4 (GND), U$5.5 (GND), X2.1, X2.6, X3.2, X4.2, X6.3, X7.1, X8.1, X9.1
GREEN_SLAVE: R12.1, SLAVE.5 (PD3)
INT_LORA: SLAVE.4 (PD2), U$2.DIO0
MODE: MASTER.14 (PB0), R1.2, S1.2, SLAVE.14 (PB0)
unnamed: MASTER.13 (PD7), R6.1
unnamed: LEDTEL3.A, R10.1
unnamed: LEDTEL2.A, R9.1
unnamed: ..A, R3.1
unnamed: 5V.A, R15.2
unnamed: LED2.3 (BLUE_A), R11.2
unnamed: LED2.1 (GREEN_A), R12.2
unnamed: LED2.2 (RED_A), R13.2
unnamed: 3V3.A, R14.2
unnamed: C6.1, MASTER.10 (PB7), Q2.2
unnamed: LEDTEL4.A, R6.2
unnamed: C3.1, Q1.1, SLAVE.9 (PB6)
unnamed: C4.1, Q1.2, SLAVE.10 (PB7)
unnamed: C5.1, MASTER.9 (PB6), Q2.1
unnamed: U$1.RFGND, U$4.2 (GND), U$4.3 (GND), U$4.4 (GND), U$4.5 (GND)
RED_SLAVE: R13.1, SLAVE.12 (PD6)
RESET_MASTER: MASTER.1 (PC6), R7.2, S4.2, SV2.3
RESET_SLAVE: R2.2, S2.2, SLAVE.1 (PC6), SV1.3
RX.GPS: MASTER.17 (PB3), X2.3
RX.UBK: MASTER.6 (PD4), X3.3
RX_MASTER: MASTER.2 (PD0), SV2.2
RX_SLAVE: SLAVE.2 (PD0), SV1.2
SCL: BAR.2, IC2.6 (SCL), MASTER.28 (PC5), R4.2, SLAVE.28 (PC5), X7.2, X8.2
SDA: BAR.1, IC2.5 (SDA), MASTER.27 (PC4), R8.2, SLAVE.27 (PC4), X7.3, X8.3
SD_CS.1: SLAVE.6 (PD4), U$3.2 (/CS)
SD_MISO.1: SLAVE.18 (PB4), U$2.MISO, U$3.7 (DO)
SD_MOSI.1: SLAVE.17 (PB3), U$2.MOSI, U$3.3 (DI)
SD_SCK.1: SLAVE.19 (PB5), U$2.SCK, U$3.5 (CLK)
SERVO: SLAVE.15 (PB1), X9.3
TP.GPS: MASTER.18 (PB4), R9.2, X2.4
TX.GPS: MASTER.16 (PB2), X2.2
TX.UBK: MASTER.5 (PD3), X3.4
TXD: SLAVE.11 (PD5), U$1.TXD
TX_MASTER: MASTER.3 (PD1), SV2.1
TX_SLAVE: SLAVE.3 (PD1), SV1.1
VIN: C7.1, IC1.1 (VI), U1.3 (IN), U2.3 (IN), X4.1

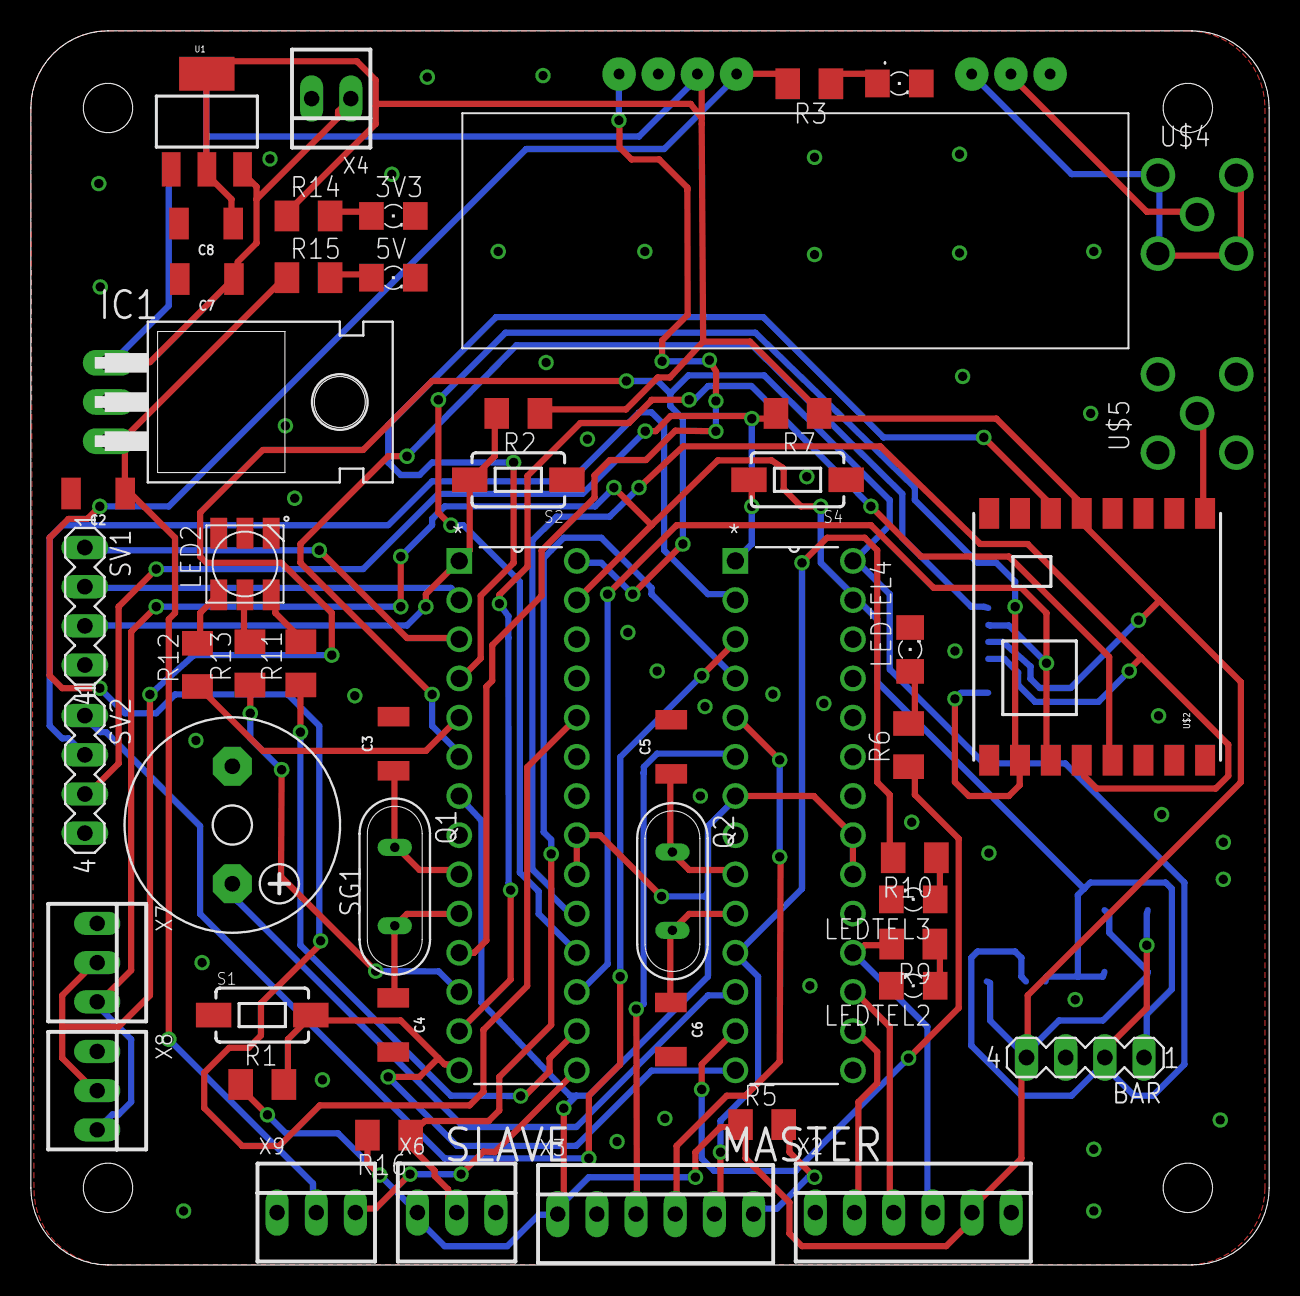
[picture p22: board garatea-board.brd from above]

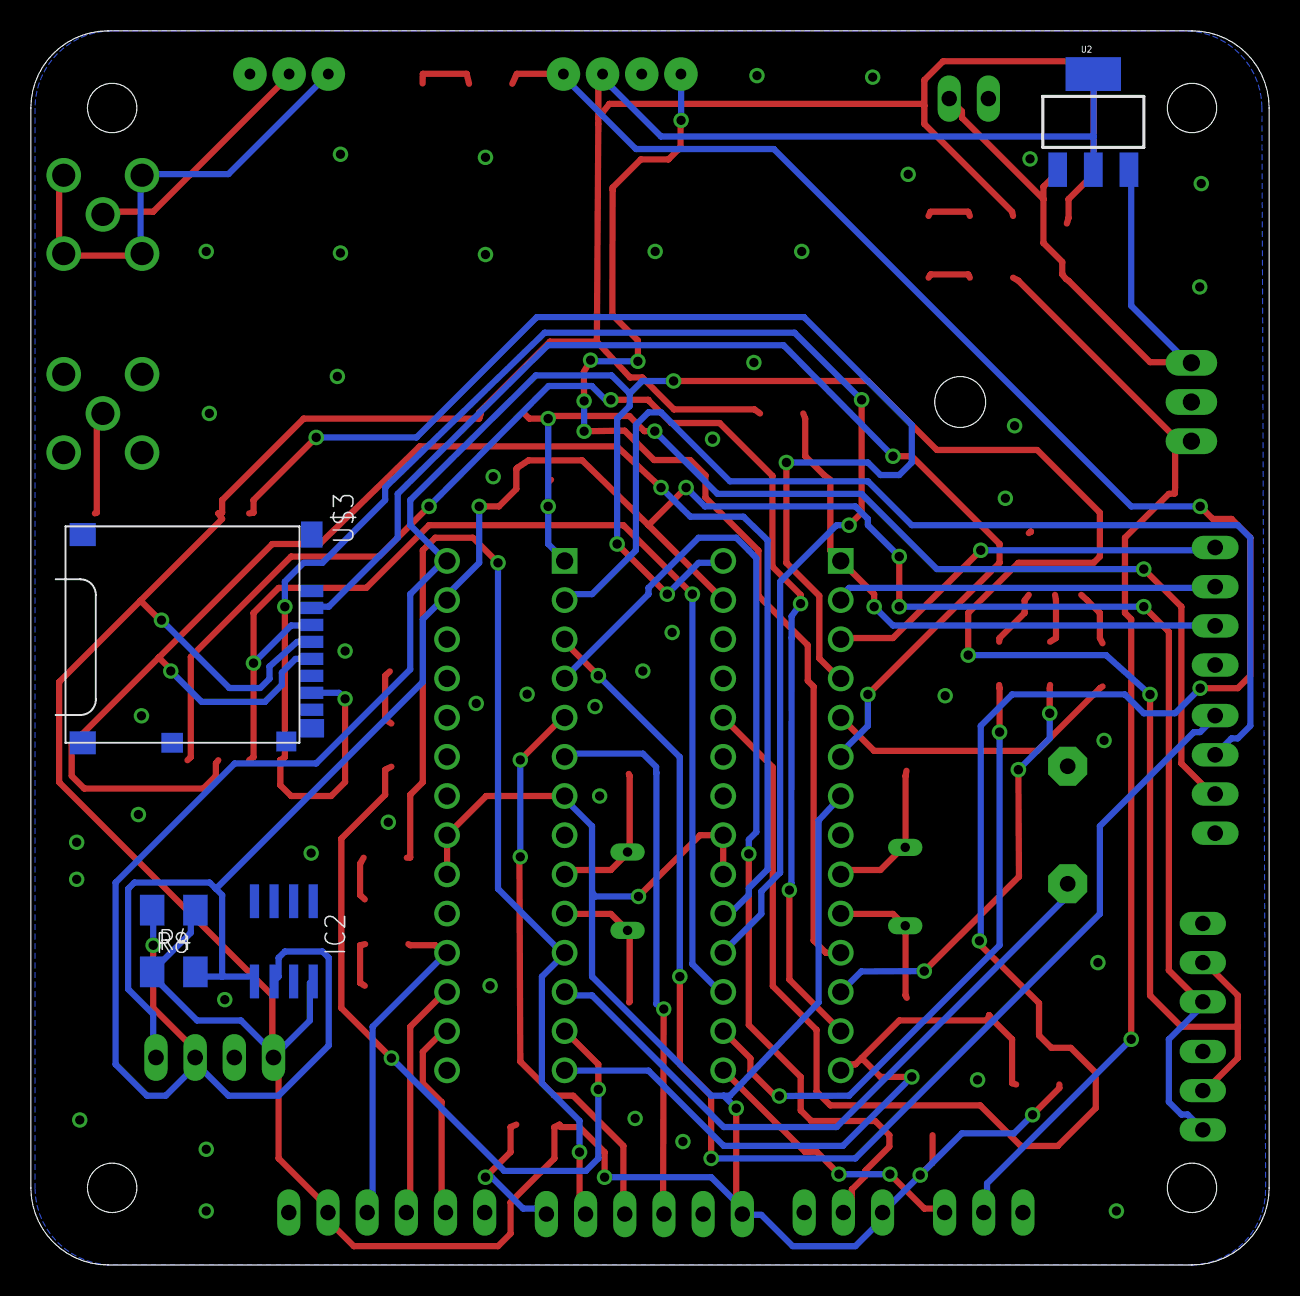
[picture p23: board garatea-board.brd from below]

Board: 2 copper layers, 80.3 x 80.0 mm, 57 parts (5 on the bottom side), 51 nets.
