zenitheesc/garatea3/Software/master/master-eng-board/hDHT.cpp

#include "hDHT.h"
#define DHTTYPE DHT22


void hDHT::readDHT(void)
{	
	this->read();
	Temp = this->readTemperature();
	Humd = this->readHumidity();
	HIdx = this->computeHeatIndex(Temp, Humd, false);
}

float hDHT::getTemp(){
    return Temp;
}

float hDHT::getHumd(){
    return Humd;
}

float hDHT::getHIdx(){
    return HIdx;
}
