zenitheesc/garatea3/(commit log)

2018-03-16 Versão com calculo de parâmetros do voo
2018-03-16 Versão com parâmetros de voo e abertura do mecanismo
2018-04-15 Versão de voo final
    Funções do servo removidas. String final montada. Frequência configurada em 433.123MHz. Pot. 20dBm, PA on.
2018-04-15 eeprom adicionada
    eeprom adicionada e um pouco de identação
2018-04-15 Compressao e inclusao de bibliotecas
2018-04-15 Leitor de eeprom
    roda o eeprom-reader.ino que ele vai ler a eeprom e vai retornar os dados pelo serial
2018-04-16 transformação mais segura de std::string pra char array
2018-04-19 Versão de voo g3 com string corrigida
    [LoRaReceiver.ino]
2021-04-19 adding hardware and structure files
    [bearing.STL, debugger-board.brd, debugger-board.sch, e-box.brd, e-box.sch, experiment-base.STL, external-assembly.cfg, external-assembly.sldasm]
